Bastardkb/dactyl-pcb-single-col/readme.md

DISCLAIMER: NOT TESTED YET ! USE AT YOUR OWN RISK.

Reviews are welcome !

## Dactyl single-col PCB

By Quentin LEBASTARD

https://bastardkb.com/

Made with Kicad nightly 5.99

## Features

- Made for Dactyl Manuform
- Will work with other 3d keyboards as long as the switch spacing is the same

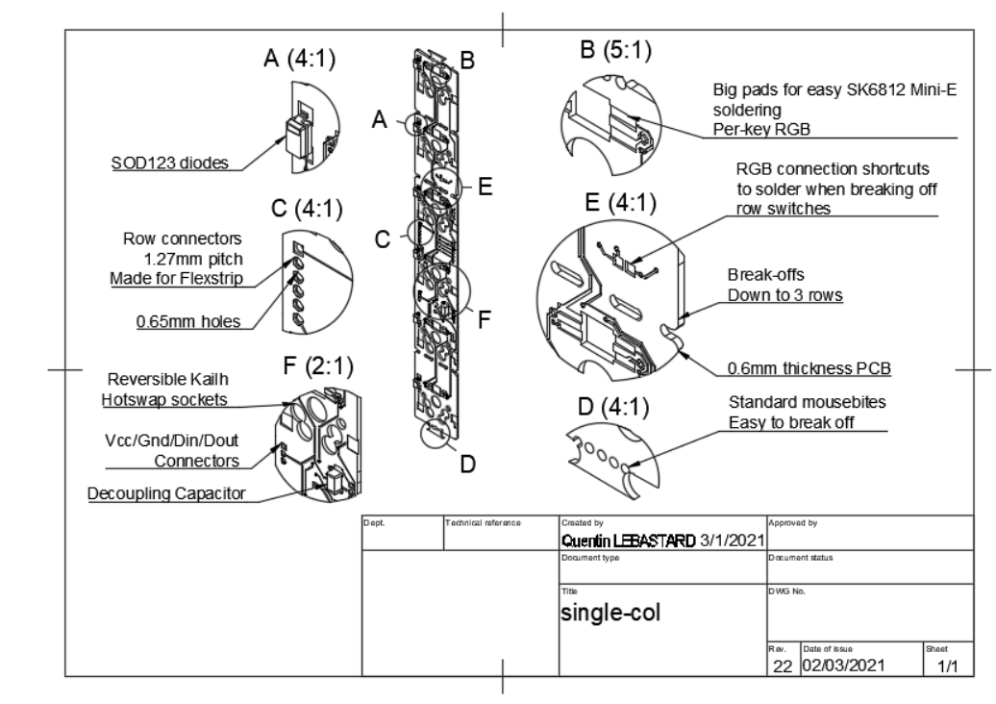
[picture p1: pics/1.PNG]


- SOD123 diodes (1206)
- SK6812 mini-e leds
- capacitors (1206, 1uF)
- 1.27mm pitch flexstrip or 28AWG wire
- made for 0.6mm thick PCB

## License

This work is licensed under a Creative Commons Attribution-NonCommercial-ShareAlike 4.0 International License.
