Bastardkb/dactyl-pcb-single-col/single-col/single-col.step

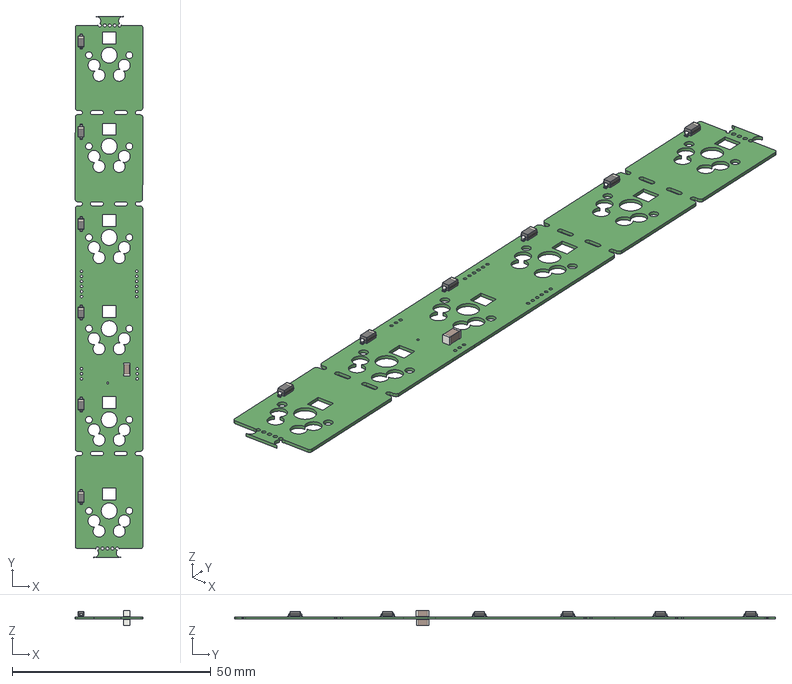
[picture p2: CAD file, 2021-03-01]
single-col/single-col.step
17.0 x 136.2 x 3.90 mm
