Bastardkb/dactyl-pcb-single-col/(commit log)

2021-03-01 add libs and edge cuts
    [single-col.kicad_pcb, single-col.kicad_sch]
2021-03-01 place leds
    [single-col.kicad_pcb, single-col.kicad_sch]
2021-03-01 place breakoffs
    [single-col.kicad_pcb, single-col.kicad_sch]
2021-03-01 route leds
    [single-col.kicad_pcb]
2021-03-01 add led shortcut pads
    [single-col.kicad_pcb, single-col.kicad_sch, single-col.step]
2021-03-01 fix diode silkscreen
    [single-col.kicad_pcb]
2021-03-02 add gnd zone
    [single-col.kicad_pcb]
2021-03-04 invert rows and cols
    [single-col.kicad_sch]
2021-03-04 update labels on pcb
    [single-col.kicad_pcb]
